emilerenaud/RoverDriveBrushless/Pièce1.SLDPRT

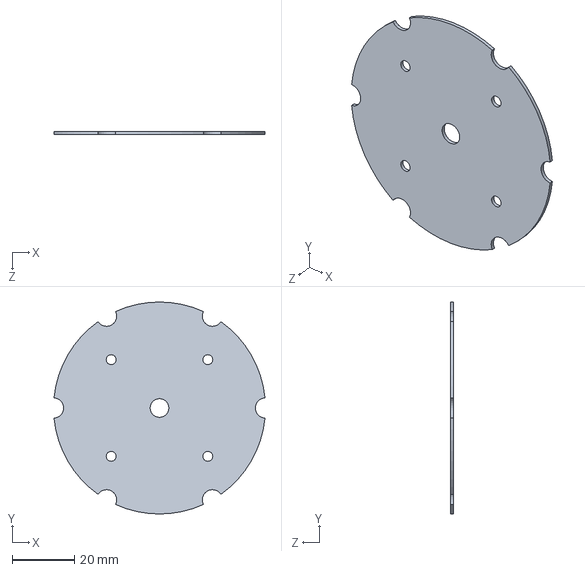
[picture p1: CAD file, 2024-12-12]
Pièce1.SLDPRT
67.7 x 68.0 x 1.00 mm
