emilerenaud/RoverDriveBrushless/shape.DXF

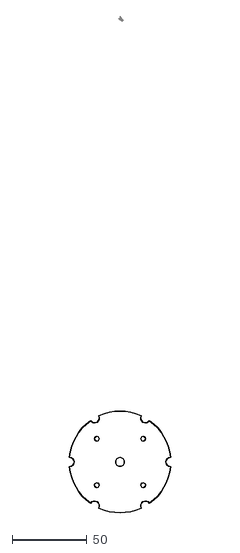
[picture p2: CAD file, 2024-12-12]
shape.DXF
67.7 x 332.3
