emilerenaud/RoverDriveBrushless/Project Outputs for roverDriveBrushless/PDF/Schematic Prints.PDF

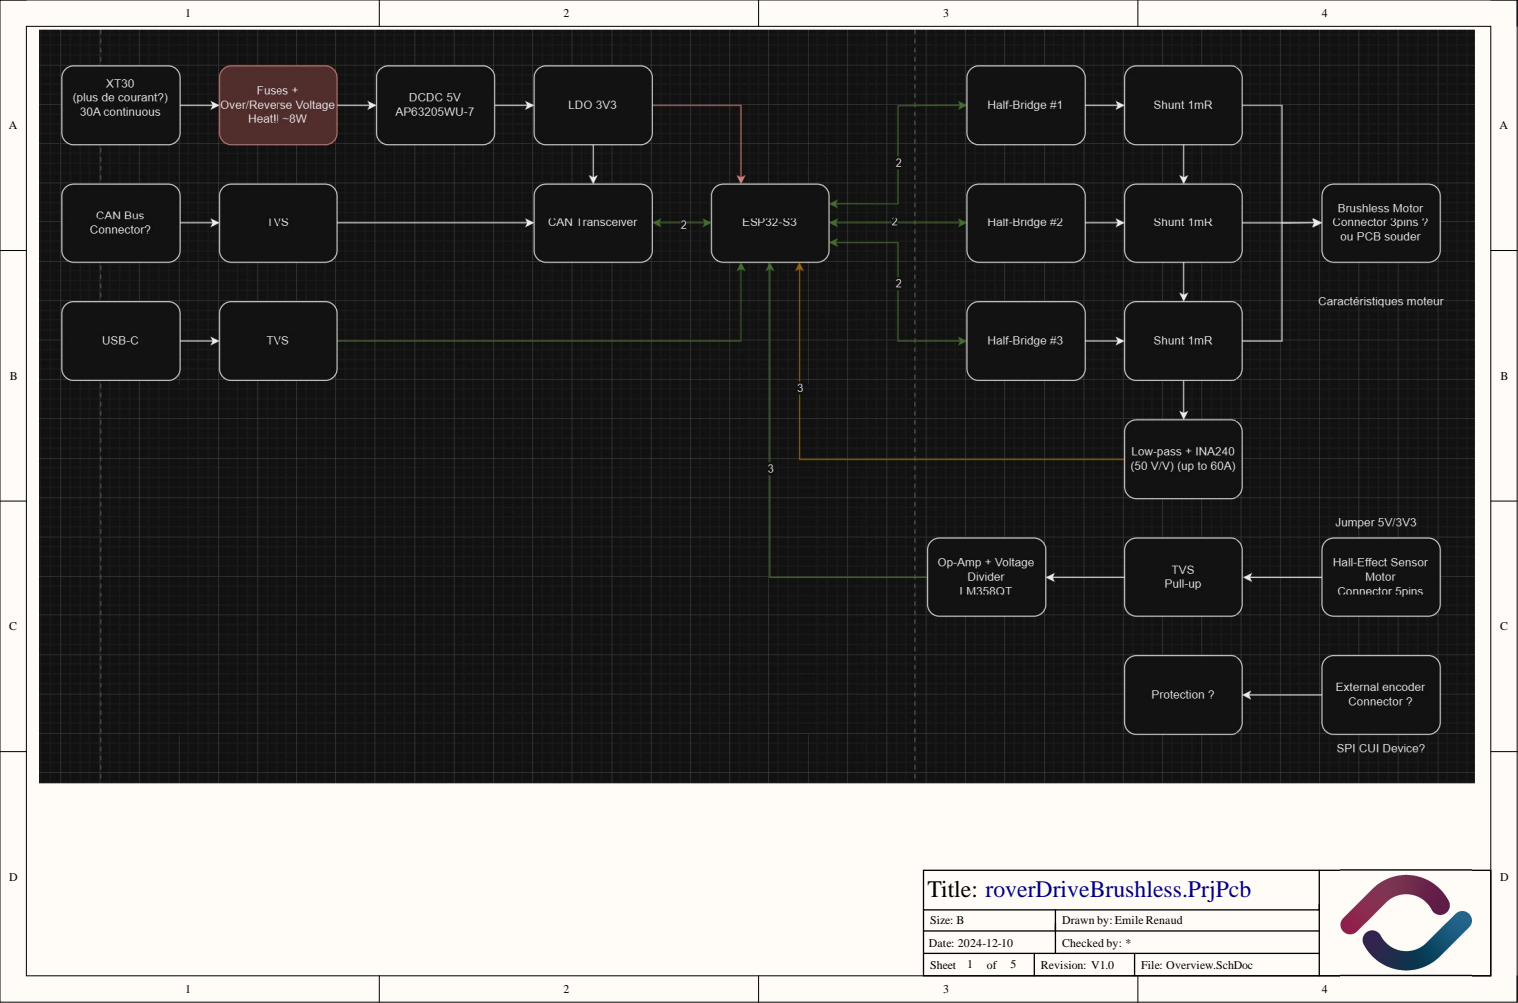
[picture p3: page 1]

Title: roverDriveBrushless.PrjPcb

Size: B | Drawn by: Emile Renaud

Date: 2024-12-10 | Checked by: *

1 5 Sheet of | V1.0 Revision: | Overview.SchDoc File:

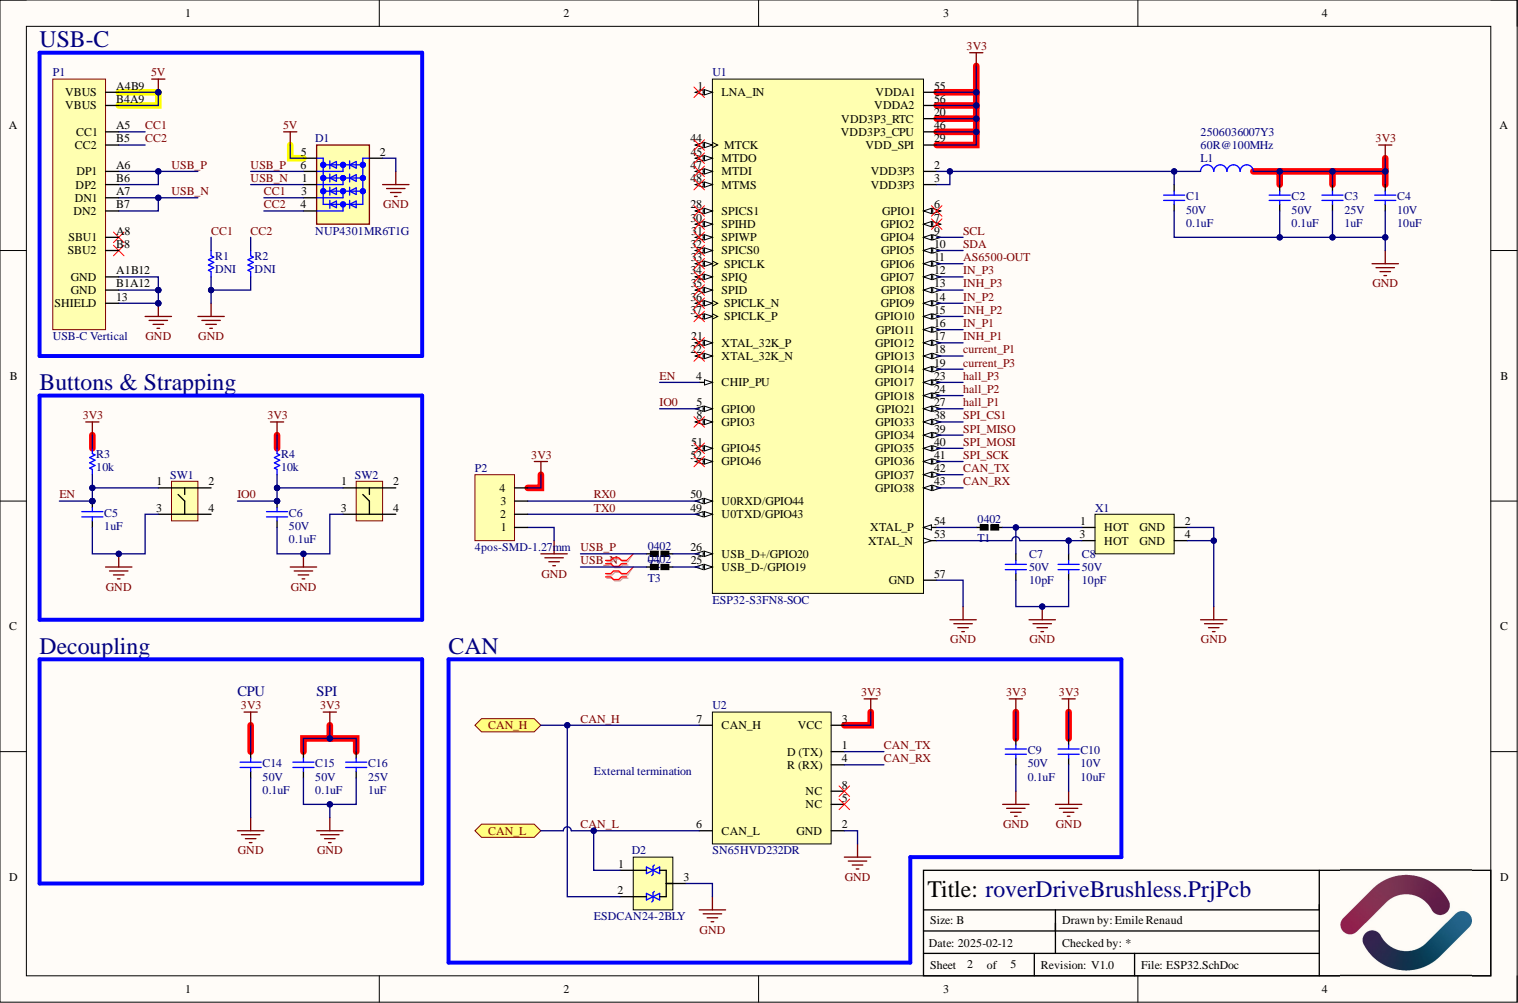
[picture p4: page 2]

4 6
2 9

Dat e : 5-0 - | Checked b y : *

Shee t o f | Rev i s i o n : V . | Fi l e : ESP3 2.Sch D o c

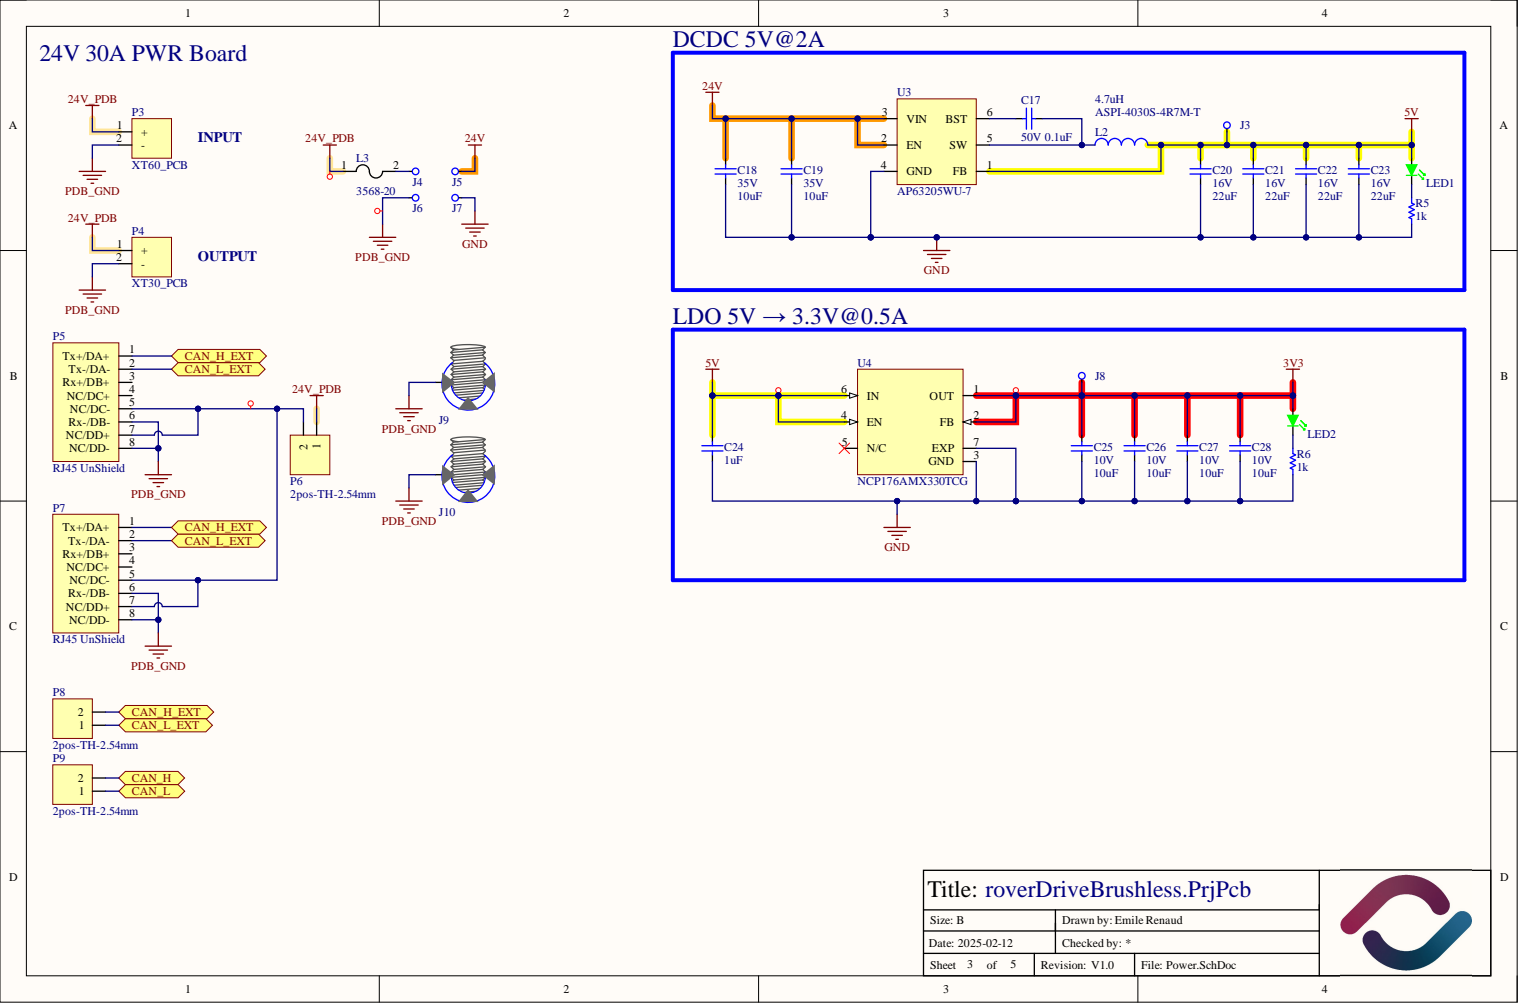
[picture p5: page 3]

3 5 | V1.0 | Power.SchDoc

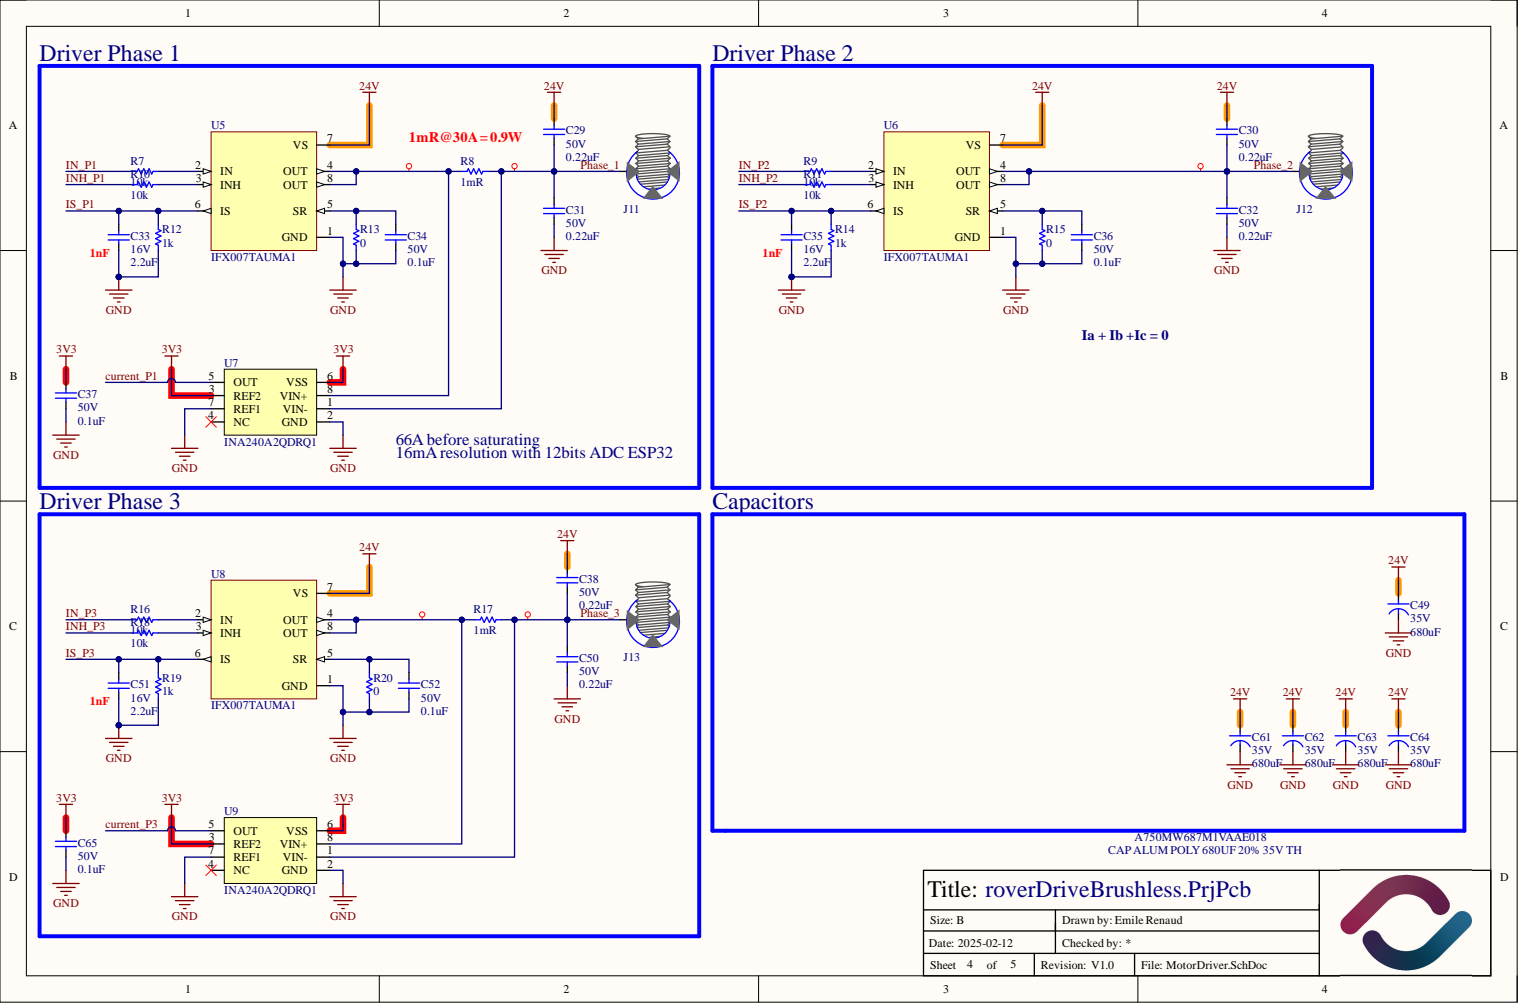
[picture p6: page 4]

66A before saturating 16mA resolution with 12bits ADC ESP32

A750MW687M1VAAE018
CAP ALUM POLY 680UF 20% 35V TH

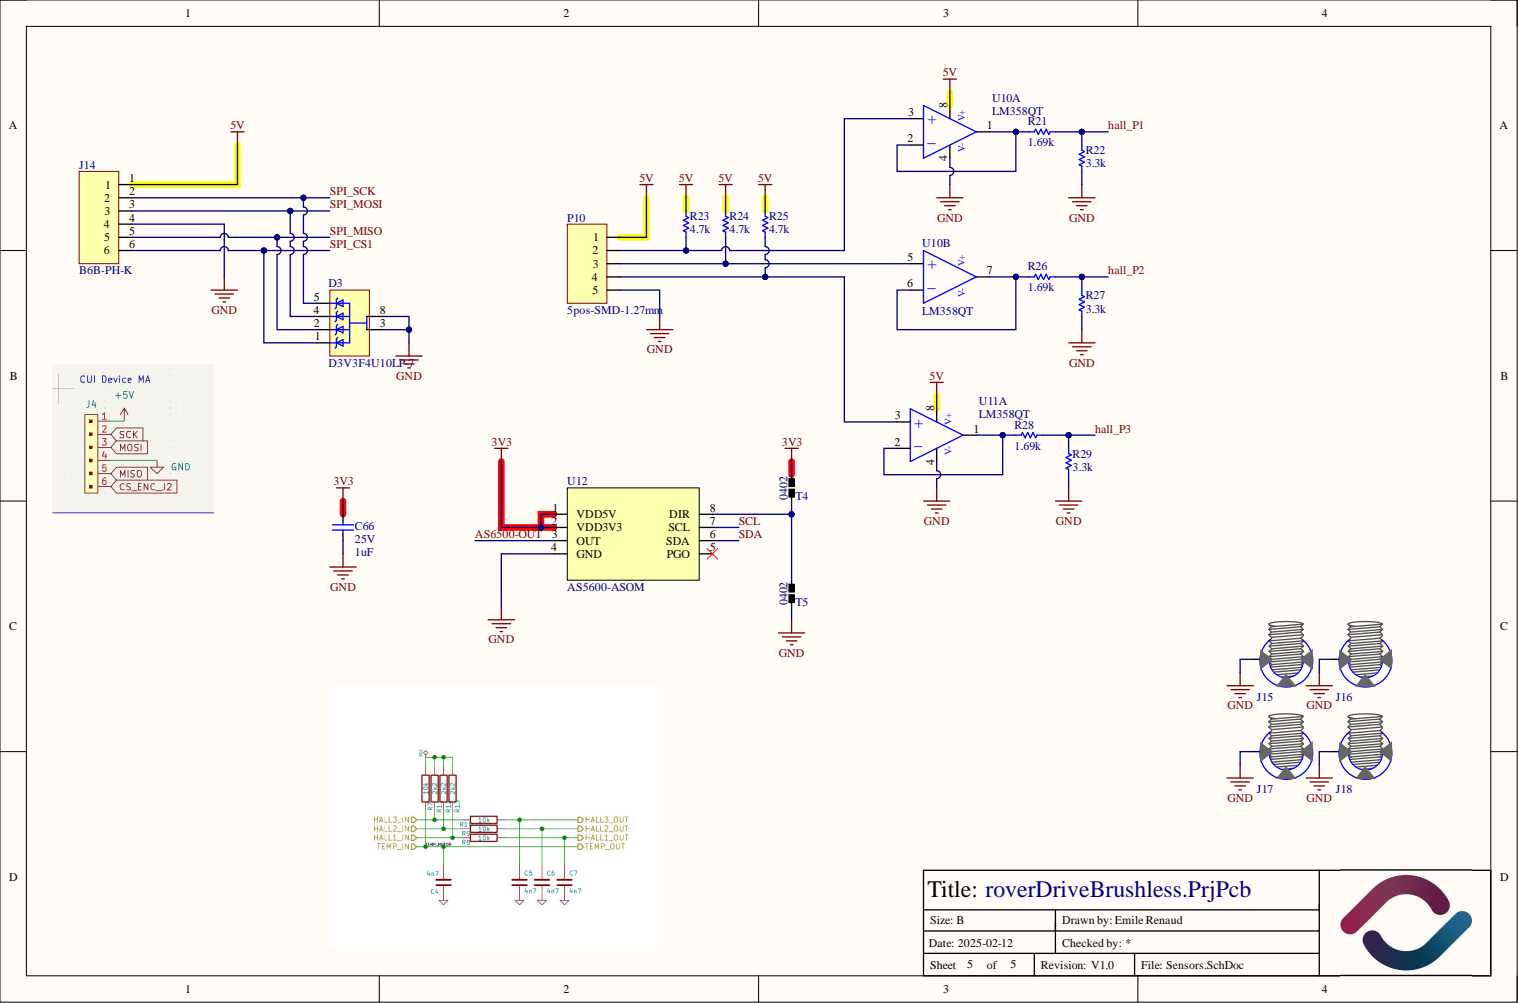
[picture p7: page 5]
