emilerenaud/RoverDriveBrushless/(list of files, drawings)

Other design files:
ESP32.SchDoc
MotorDriver.SchDoc
Overview.SchDoc
Power.SchDoc
roverDriveBrushless.PcbDoc
roverDriveBrushless.PrjPcb
Sensors.SchDoc
