emilerenaud/RoverDriveBrushless/(commit log)

2024-12-10 add basic files
    [ESP32.SchDoc, Overview.SchDoc, Power.SchDoc, roverDriveBrushless.PrjPcb]
2024-12-10 basic circuit
    [ESP32.SchDoc, MotorDriver.SchDoc, Overview.SchDoc, Power.SchDoc, roverDriveBrushless.PrjPcb]
2024-12-10 add cap + sensor
    [ESP32.SchDoc, MotorDriver.SchDoc, Power.SchDoc, Sensors.SchDoc, roverDriveBrushless.PrjPcb]
2024-12-11 starting layout
    [MotorDriver.SchDoc, roverDriveBrushless.PcbDoc]
2024-12-12 change shunt
    [ESP32.SchDoc, MotorDriver.SchDoc]
2024-12-13 layout power
    [Sensors.SchDoc]
2024-12-18 group components
    [Power.SchDoc]
2024-12-18 layout dcdc ldo 5V 3V3
    [ESP32.SchDoc, MotorDriver.SchDoc, Power.SchDoc, Sensors.SchDoc, roverDriveBrushless.PrjPcb]
2024-12-18 layout power 24V
2025-03-13 finished layout + gerber
    [BOM-roverDriveBrushless.xlsx, ESP32.SchDoc, MotorDriver.SchDoc, Power.SchDoc, Sensors.SchDoc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]
